Samatthe/TTL-HW/README.md

# TTL-HW
Hardware for the TelTail Light's Control Module, an interactive lighting controller for DIY electric skateboards
