Samatthe/TTL-HW/TTL-Lights/Tail Light/1v2/Tail Lights 1v2 BOM.xlsx

Parts | Value | Device | Package
J1 |  | JST_2MM_MALE | JST-2-SMD
R1 | 51 | RESISTOR2512 | 2512
J2 |  | JST_PH_2POS | JST_PH_2POS
D1 |  | MLERED-A1-0000-000V01
D2 |  | MLERED-A1-0000-000V01 | 4-SMD
D3 |  | MLERED-A1-0000-000V01 | 4-SMD
