Samatthe/TTL-HW/TTL-SP/BOM TTL SP 4v1.xlsx

# | Manufacturer Part# | Manufacturer | Value | Package | Designator | Quantity | Link | Note
1 | RMCF0603ZT0R00 | Stackpole Electronics Inc | 0 | 0603 | R19, R22 | 2 | https://www.digikey.com/product-detail/en/stackpole-electronics-inc/RMCF0603ZT0R00/RMCF0603ZT0R00CT-ND/1943218
2 | CS0603KRX7R7BB104 | Yageo | 0.1uf | 0603 | C1, C2, C3, C6, C7, C8, C20, C21 | 8 | https://www.digikey.com/product-detail/en/stackpole-electronics-inc/RMCF0402JT10K0/RMCF0402JT10K0CT-ND/1942936
3 | ERJ-P06J101V | Panasonic Electronic Components | 100 | 0805 | R35 | 1 | https://www.digikey.com/product-detail/en/panasonic-electronic-components/ERJ-P06J101V/P100ADCT-ND/525436
4 | RMCF0402JT10K0 | Stackpole Electronics Inc | 10k | 0402 | R1, R15, R16, R18, R20, R24, R25, R26, R27, R28, R29, R30, R31, R32, R33, R34 | 16 | https://www.digikey.com/product-detail/en/stackpole-electronics-inc/RMCF0402JT10K0/RMCF0402JT10K0CT-ND/1942936
5 | CL10X106MO8NRNC | Samsung Electro-Mechanics | 10uF, 16v | 0603 | C9 | 1 | https://www.digikey.com/product-detail/en/samsung-electro-mechanics/CL10X106MO8NRNC/1276-6769-1-ND/5961628
6 | CL10A106MA8NRNC | Samsung Electro-Mechanics | 10uF, 25v | 0603 | C10 | 1 | https://www.digikey.com/product-detail/en/samsung-electro-mechanics/CL10A106MA8NRNC/1276-1869-1-ND/3889955
7 | AIML-0603-100K-T | Abracon LLC | 10uH | 0603 | L1 | 1 | https://www.digikey.com/product-detail/en/abracon-llc/AIML-0603-100K-T/535-11587-1-ND/2782850
8 | RMCF0402FT140K | Stackpole Electronics Inc. | 140k | 0402 | R12 | 1 | https://www.digikey.com/product-detail/en/stackpole-electronics-inc/RMCF0402FT140K/RMCF0402FT140KCT-ND/5049718
9 | RMCF0402FT15K4 | Stackpole Electronics Inc | 15.4k | 0402 | R11 | 1 | https://www.digikey.com/product-detail/en/stackpole-electronics-inc/RMCF0402FT15K4/RMCF0402FT15K4CT-ND/6053094
10 | C1608C0G2A150J080AA | TDK Corporation | 15pf | 0603 | C4, C5 | 2 | https://www.digikey.com/product-detail/en/tdk-corporation/C1608C0G2A150J080AA/445-14008-1-ND/3955674
11 | ERJ-2RKF1743X | Panasonic Electronic Components | 174k | 0402 | R10 | 1 | https://www.digikey.com/product-detail/en/panasonic-electronic-components/ERJ-2RKF1743X/P174KLCT-ND/194213
12 | RMCF0402JT1K00 | Stackpole Electronics Inc | 1k | 0402 | R23 | 1 | https://www.digikey.com/product-detail/en/stackpole-electronics-inc/RMCF0402JT1K00/RMCF0402JT1K00CT-ND/1942934
13 | 1206L110/16WR | Littelfuse Inc. | 1.1A | 1206 | F1 | 1 | https://www.digikey.com/product-detail/en/littelfuse-inc/1206L110-16WR/18-1206L110-16WRCT-ND/10671937
14 | CGA6M3X7R1H225K200AB | TDK Corporation | 2.2uf | 1210 | C22 | 1 | https://www.digikey.com/product-detail/en/tdk-corporation/CGA6M3X7R1H225K200AB/445-5715-1-ND/2443755
15 | UZR1H2R2MCL1GB | Nichicon | 2.2uf | PANASONIC_B (4.30mm x 4.30mm) | C13 | 1 | https://www.digikey.com/product-detail/en/nichicon/UZR1H2R2MCL1GB/493-10122-1-ND/3983967
16 | GCM155R71H223KA55D | Murata Electronics North America | 22nf | 0402 | C14 | 1 | https://www.digikey.com/product-detail/en/murata-electronics-north-america/GCM155R71H223KA55D/490-4763-1-ND/1641682
17 | RMCF0402FT274K | Stackpole Electronics Inc | 274k | 0402 | R13 | 1 | https://www.digikey.com/product-detail/en/stackpole-electronics-inc/RMCF0402FT274K/RMCF0402FT274KCT-ND/6052917
18 | ABS07-32.768KHZ-T | Abracon LLC | 32.768kHz | SMD-3.2X1.5MM | Y1 | 1 | https://www.digikey.com/product-detail/en/abracon-llc/ABS07-32.768KHZ-T/535-9542-1-ND/1237009
19 | RMCF0402JT330R | Stackpole Electronics Inc | 330 | 0402 | R2, R3, R4, R5, R6, R7, R8, R9, R17, R21, R36 | 11 | https://www.digikey.com/product-detail/en/stackpole-electronics-inc/RMCF0402JT330R/RMCF0402JT330RCT-ND/2417869
20 | RMCF0603JT470K | Stackpole Electronics Inc. | 470k | 0603 | R14 | 1 | https://www.digikey.com/product-detail/en/stackpole-electronics-inc/RMCF0603JT470K/RMCF0603JT470KCT-ND/1943209
21 | GRM32EC81C476KE15K | Murata Electronics | 47uf | 1210 | C11, C12, C15 | 3 | https://www.digikey.com/product-detail/en/murata-electronics/GRM32EC81C476KE15K/490-16309-1-ND/7363291
22 | BC846B RFG | Taiwan Semiconductor Corporation | N/A | SOT23-3 | Q5, Q6 | 2 | https://www.digikey.com/product-detail/en/taiwan-semiconductor-corporation/BC846B-RFG/BC846BRFGCT-ND/7644289
23 | ATSAMD21G18A-AUT | Microchip Technology | N/A | 48-TQFP | U1 | 1 | https://www.digikey.com/product-detail/en/microchip-technology/ATSAMD21G18A-AUT/ATSAMD21G18A-AUTCT-ND/4878879
24 | AZ1117EH-3.3TRG1 | Diodes Incorporated | AZ1117EH-3.3 | SOT-223 | U4 | 1 | https://www.digikey.com/product-detail/en/diodes-incorporated/AZ1117EH-3.3TRG1/AZ1117EH-3.3TRG1DICT-ND/5001336
25 | 150060BS55040 | Wurth Electronics Inc. | Blue | 0603 | D4 | 1 | https://www.digikey.com/product-detail/en/wurth-electronics-inc/150060BS55040/732-12013-1-ND/8557223
26 | DMN3135LVT-7 | Diodes Incorporated | 3.5A | TSOT26 | Q1, Q2, Q3, Q4 | 4 | https://www.digikey.com/product-detail/en/diodes-incorporated/DMN3135LVT-7/DMN3135LVT-7DICT-ND/2890884
27 | 150060VS55040 | Wurth Electronics Inc. | Green | 0603 | D1 | 1 | https://www.digikey.com/product-detail/en/wurth-electronics-inc/150060VS55040/732-12017-1-ND/8557227
28 | LMZ35003RKGT | Texas Instruments | N/A | 41-BQFN | U2 | 1 | https://www.digikey.com/product-detail/en/texas-instruments/LMZ35003RKGT/296-37034-1-ND/4485013
29 | LSM6DSMTR | STMicroelectronics | N/A | 14-VFLGA | U7 | 1 | https://www.digikey.com/product-detail/en/stmicroelectronics/LSM6DSMTR/497-16696-1-ND/6192778
30 | PMEG6020ER,115 | Nexperia USA Inc. | .5v, 2A | SOD-123W | D3, D5 | 2 | https://www.digikey.com/product-detail/en/nexperia-usa-inc/PMEG6020ER,115/1727-5217-1-ND/2531816
31 | PSMN012-60YS,115 | Nexperia USA Inc. | 60v, 59A | LFPAK56, Power-SO8 | U6 | 1 | https://www.digikey.com/product-detail/en/nexperia-usa-inc/PSMN012-60YS,115/1727-4288-1-ND/2206354
32 | MPZ1608D300BTD25 | TDK Corporation | 30 Ohms @ 100MHz | 0603 | L2 | 1 | https://www.digikey.com/product-detail/en/tdk-corporation/MPZ1608D300BTD25/445-172886-1-ND/5040517
33 | SS215-HF | Comchip Technology | 100v, 2A | DO-214AC, SMA | D2 | 1 | https://www.digikey.com/product-detail/en/comchip-technology/SS215-HF/641-SS215-HFCT-ND/10443823
34 | USB3160-30-0170-1-C | GCT | N/A | N/A | J1 | 1 | https://www.digikey.com/product-detail/en/gct/USB3160-30-0170-1-C/2073-USB3160-30-0170-1-CCT-ND/9859727
