Samatthe/TTL-HW/TTL-Breakout/3D Parts/Pogo Cover.stl

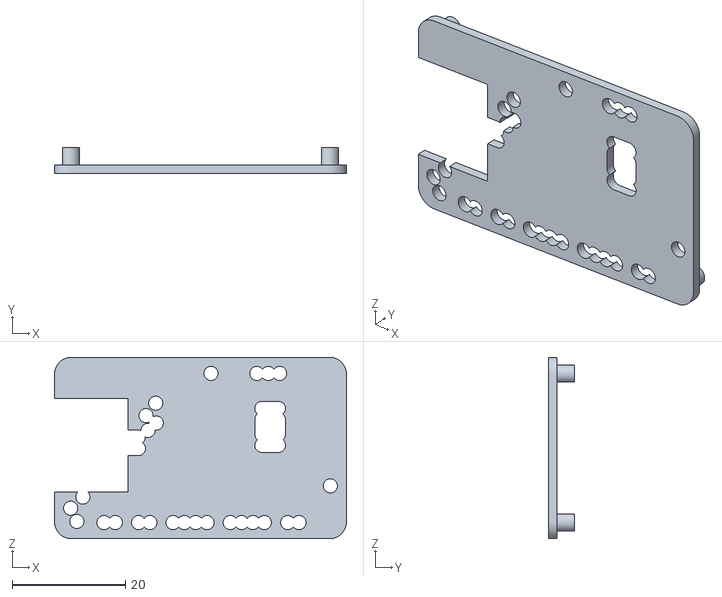
[picture p1: CAD file, 2023-09-26]
TTL-Breakout/3D Parts/Pogo Cover.stl
51.5 x 4.50 x 32.0
