Samatthe/TTL-HW/TTL-EP/3D Models/TTL EP Cover 2v1.stl

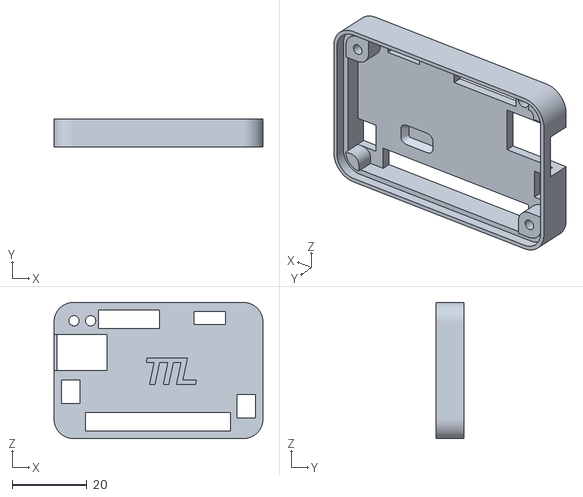
[picture p2: CAD file, 2023-09-26]
TTL-EP/3D Models/TTL EP Cover 2v1.stl
55.9 x 7.60 x 36.4
