Samatthe/TTL-HW/TTL-Lights/3D Models/Head Cover.stl

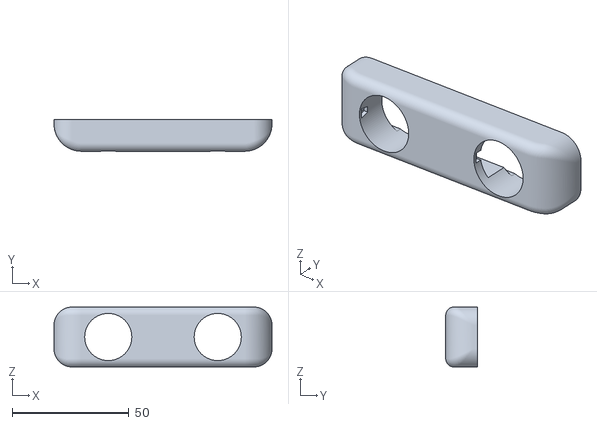
[picture p3: CAD file, 2023-09-26]
TTL-Lights/3D Models/Head Cover.stl
93.6 x 13.5 x 25.7
