Samatthe/TTL-HW/TTL-EP/3D Models/TTL EP Base 2v1.stl

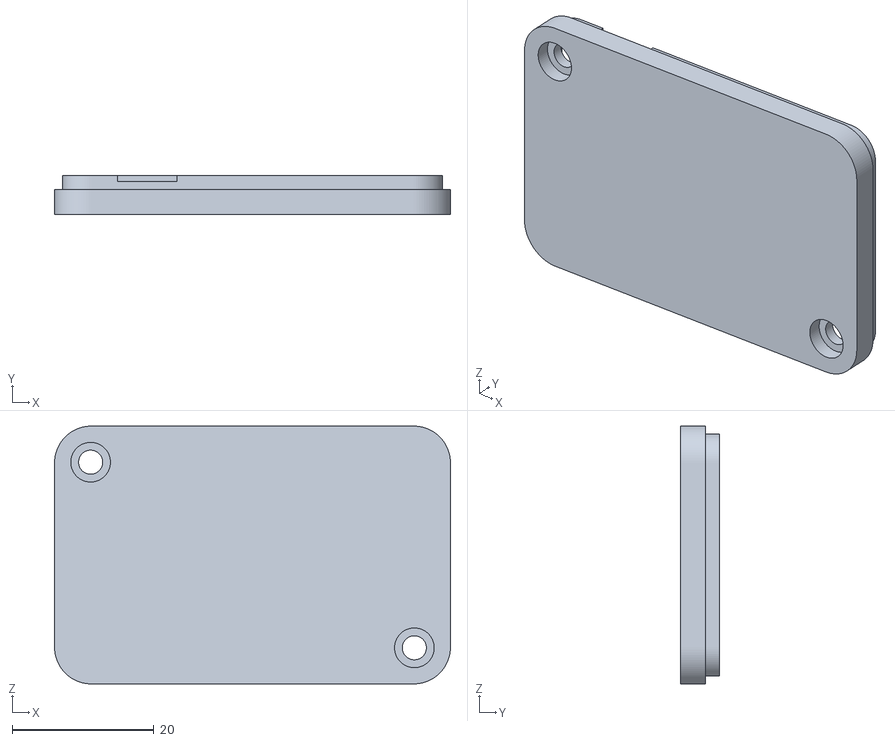
[picture p5: CAD file, 2023-09-26]
TTL-EP/3D Models/TTL EP Base 2v1.stl
55.9 x 5.50 x 36.4
