Samatthe/TTL-HW/TTL-Lights/3D Models/Light Mount.stl

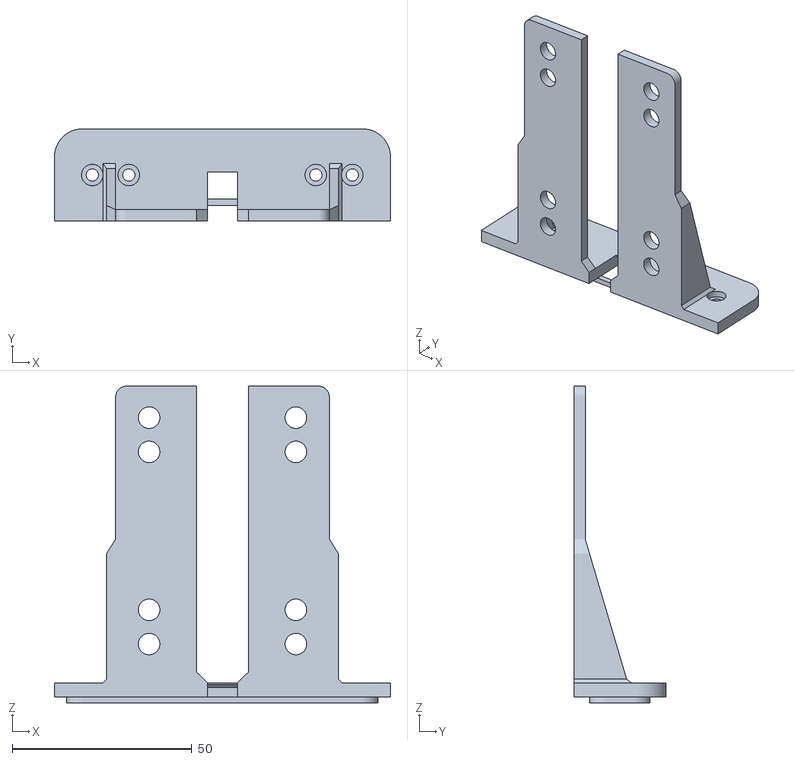
[picture p6: CAD file, 2023-09-26]
TTL-Lights/3D Models/Light Mount.stl
93.6 x 25.7 x 88.2
