Samatthe/TTL-HW/TTL-SP/3D Models/TTL SP Cover 4v1 - Printed.stl

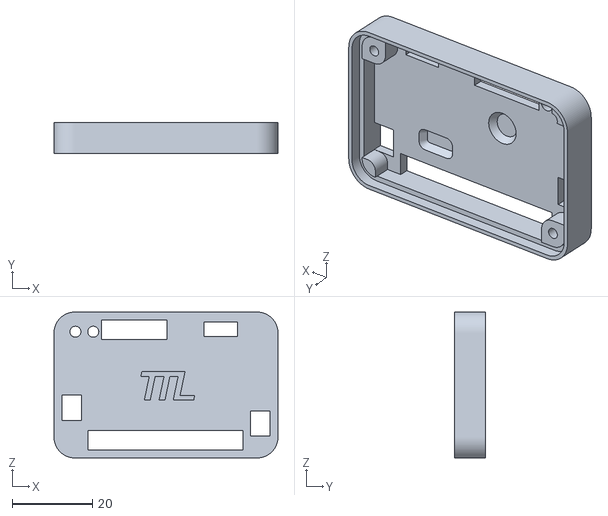
[picture p7: CAD file, 2023-09-26]
TTL-SP/3D Models/TTL SP Cover 4v1 - Printed.stl
55.9 x 7.80 x 36.4
