Samatthe/TTL-HW/TTL-Lights/3D Models/LightCover - Tail 45 deg.stl

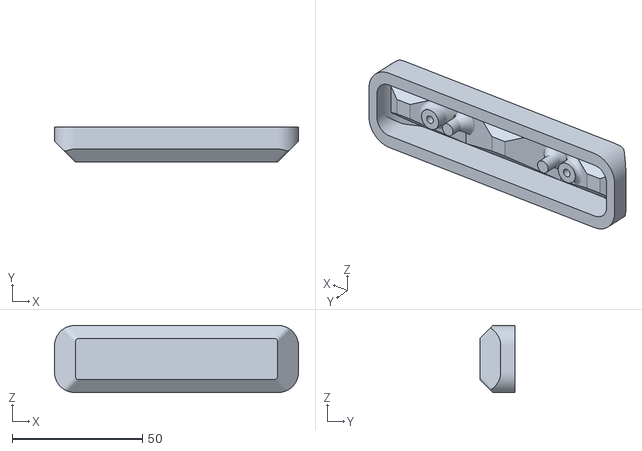
[picture p8: CAD file, 2023-09-26]
TTL-Lights/3D Models/LightCover - Tail 45 deg.stl
93.6 x 13.5 x 25.7
