Samatthe/TTL-HW/TTL-SP/3D Models/Cover SP Metal v29.step

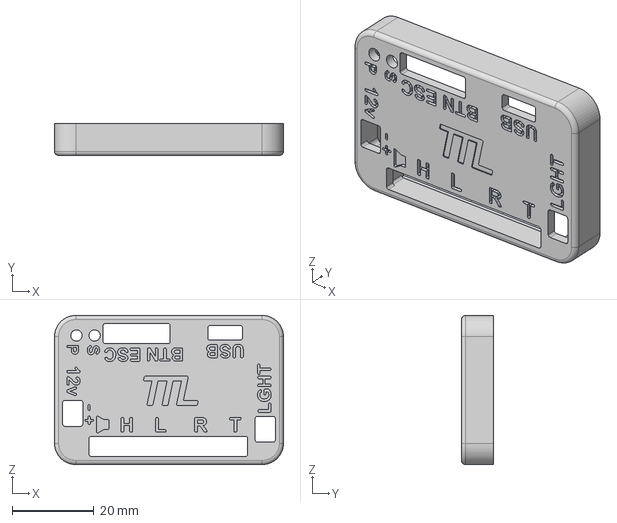
[picture p9: CAD file, 2023-09-26]
TTL-SP/3D Models/Cover SP Metal v29.step
55.9 x 7.80 x 36.4 mm
