Samatthe/TTL-HW/TTL-SP/3D Models/Base SP - Countersunk Screw.stl

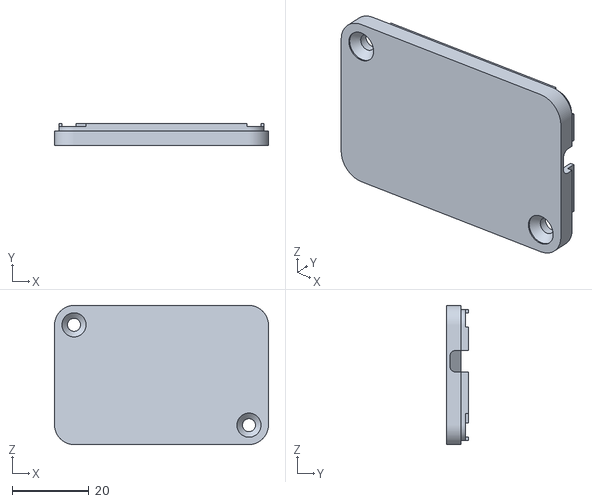
[picture p10: CAD file, 2023-09-26]
TTL-SP/3D Models/Base SP - Countersunk Screw.stl
55.9 x 5.70 x 36.4
