Samatthe/TTL-HW/(list of files, cad)

Other CAD files:
TTL-SP/3D Models/TTL SP Cover 4v1 - Metal.stl
TTL-SP/3D Models/Base SP - Pan Head Screw.stl
