Samatthe/TTL-HW/TTL-Lights/Headlight/1v2/Head Lights.brd

## EAGLE design TTL-Lights/Headlight/1v2/Head Lights.brd (2023-09-26)

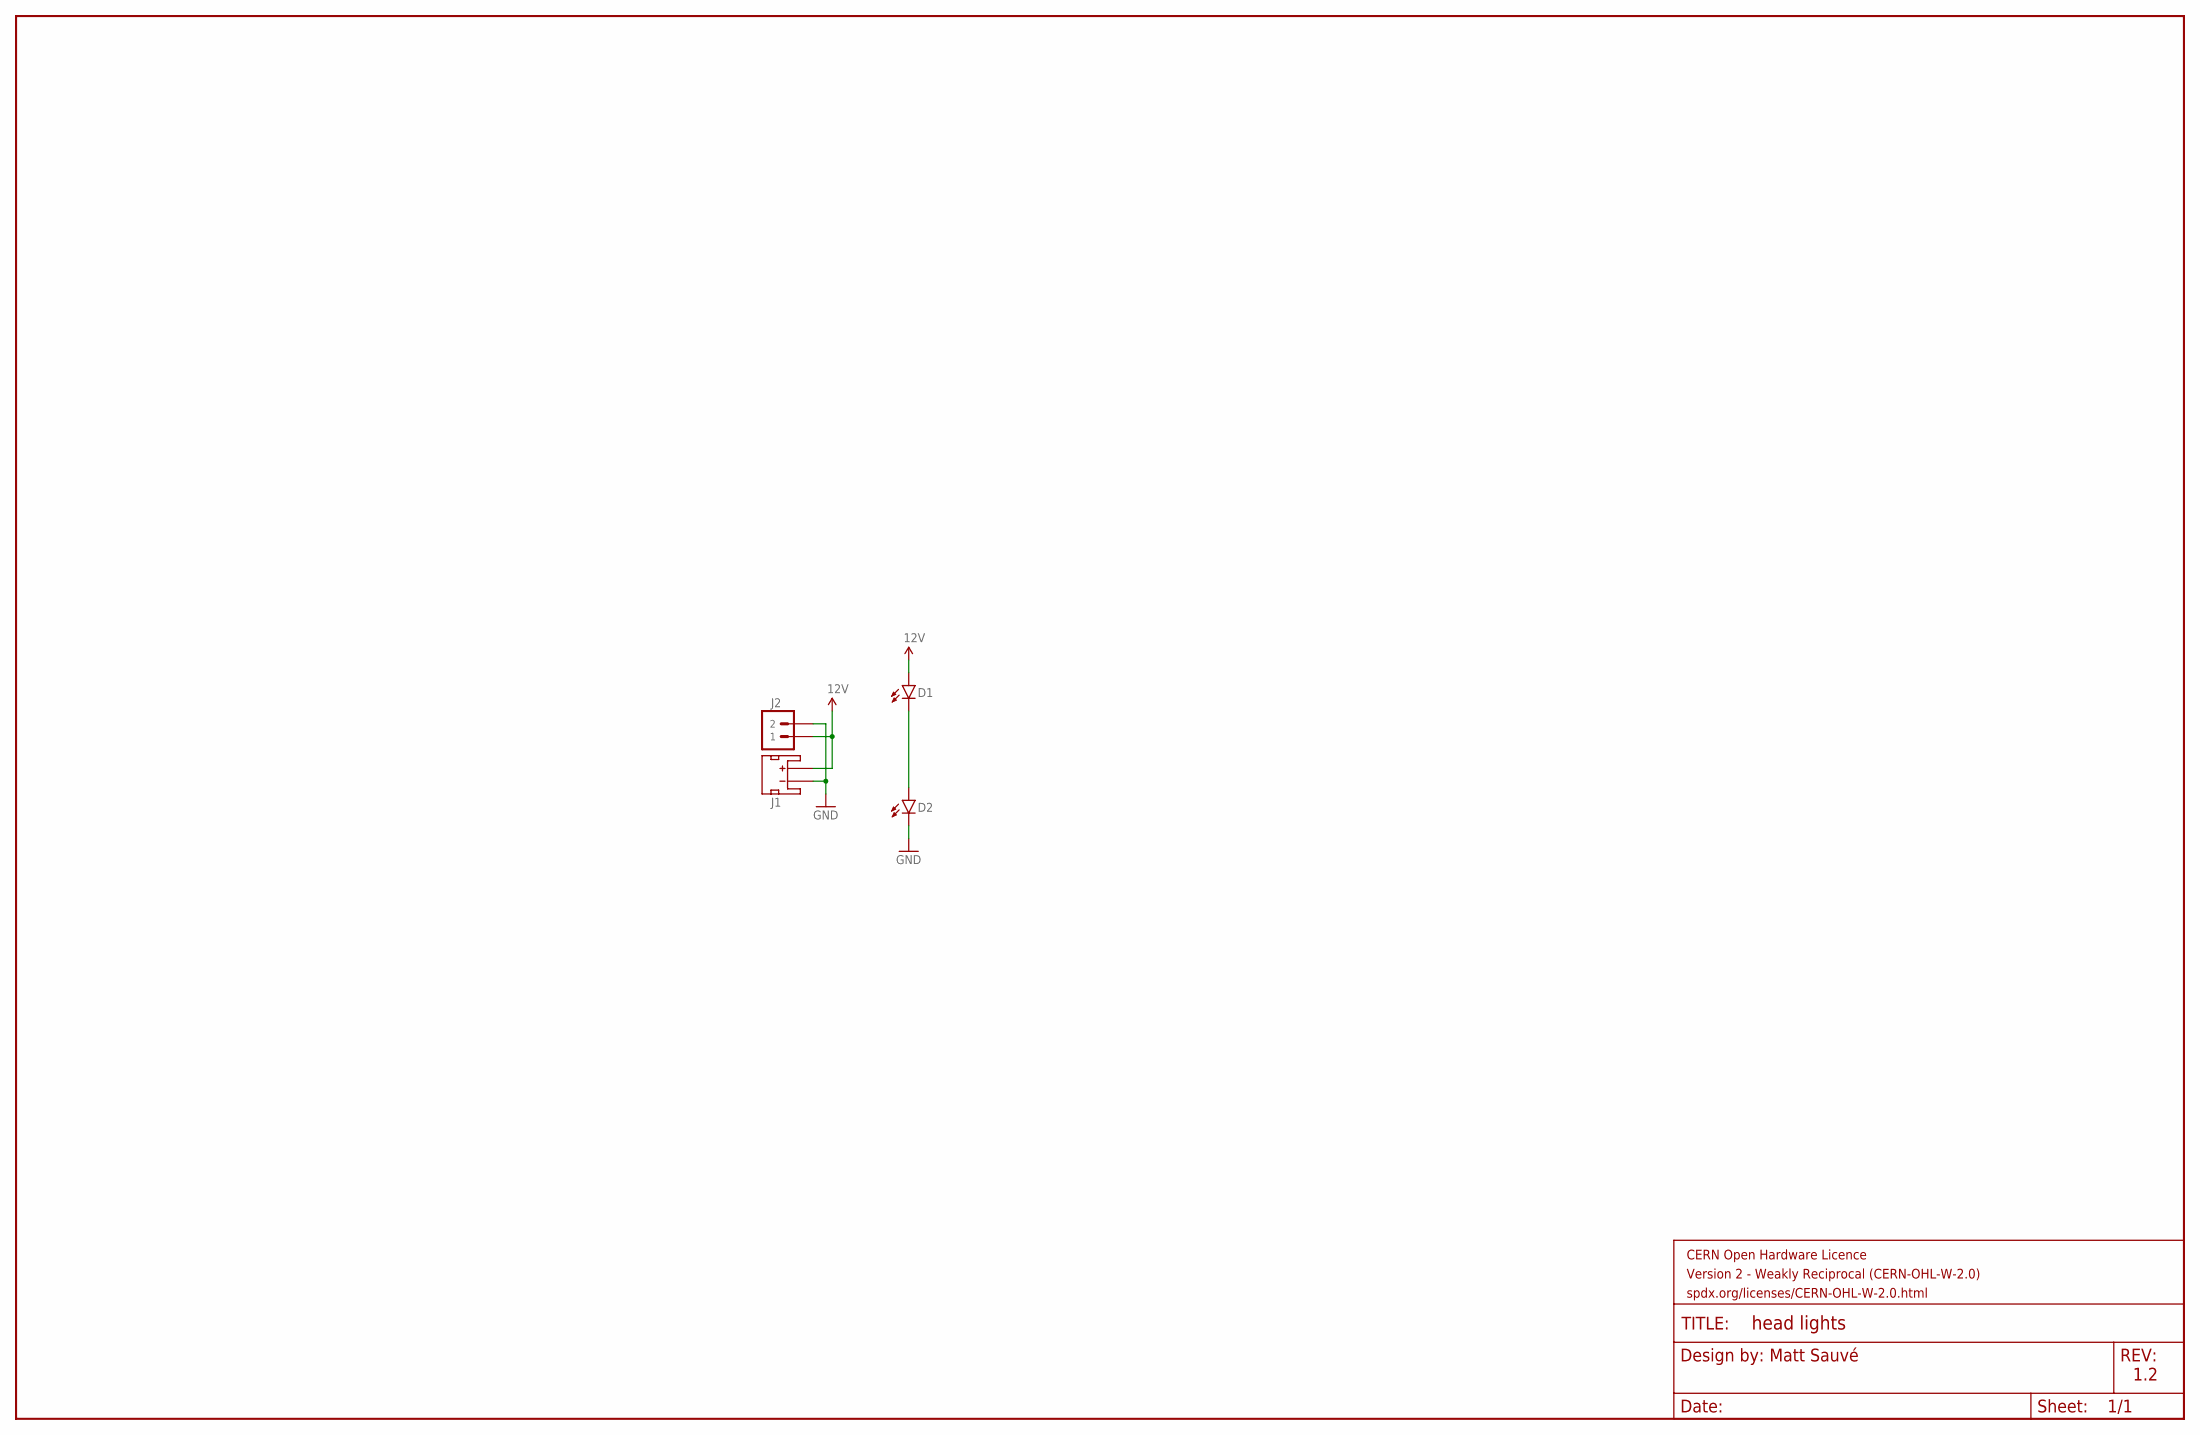
[picture p11: schematic Head Lights.sch]

Parts:
D1, D2: WHITE_LUXEON_LED; 1414
FRAME1: FRAME-LEDGER_CERN_WEAK; CERN_WEAK
J1: JST_2MM_MALE; JST-2-SMD
J2: JST_PH_2POS

Connections:
12V: D1.P$1 (A), J1.2 (+), J2.1
GND: D2.P$2 (C), J1.1 (-), J2.2
unnamed: D1.P$2 (C), D2.P$1 (A)

Notes on the sheet:
Matt Sauvé
1.2

Board: 2 copper layers, 5 parts (2 on the bottom side), 3 nets, no tracks yet.
