Samatthe/TTL-HW/TTL-Breakout/TelTail Breakout 3v0.brd

## EAGLE design TTL-Breakout/TelTail Breakout 3v0.brd (2023-09-26)

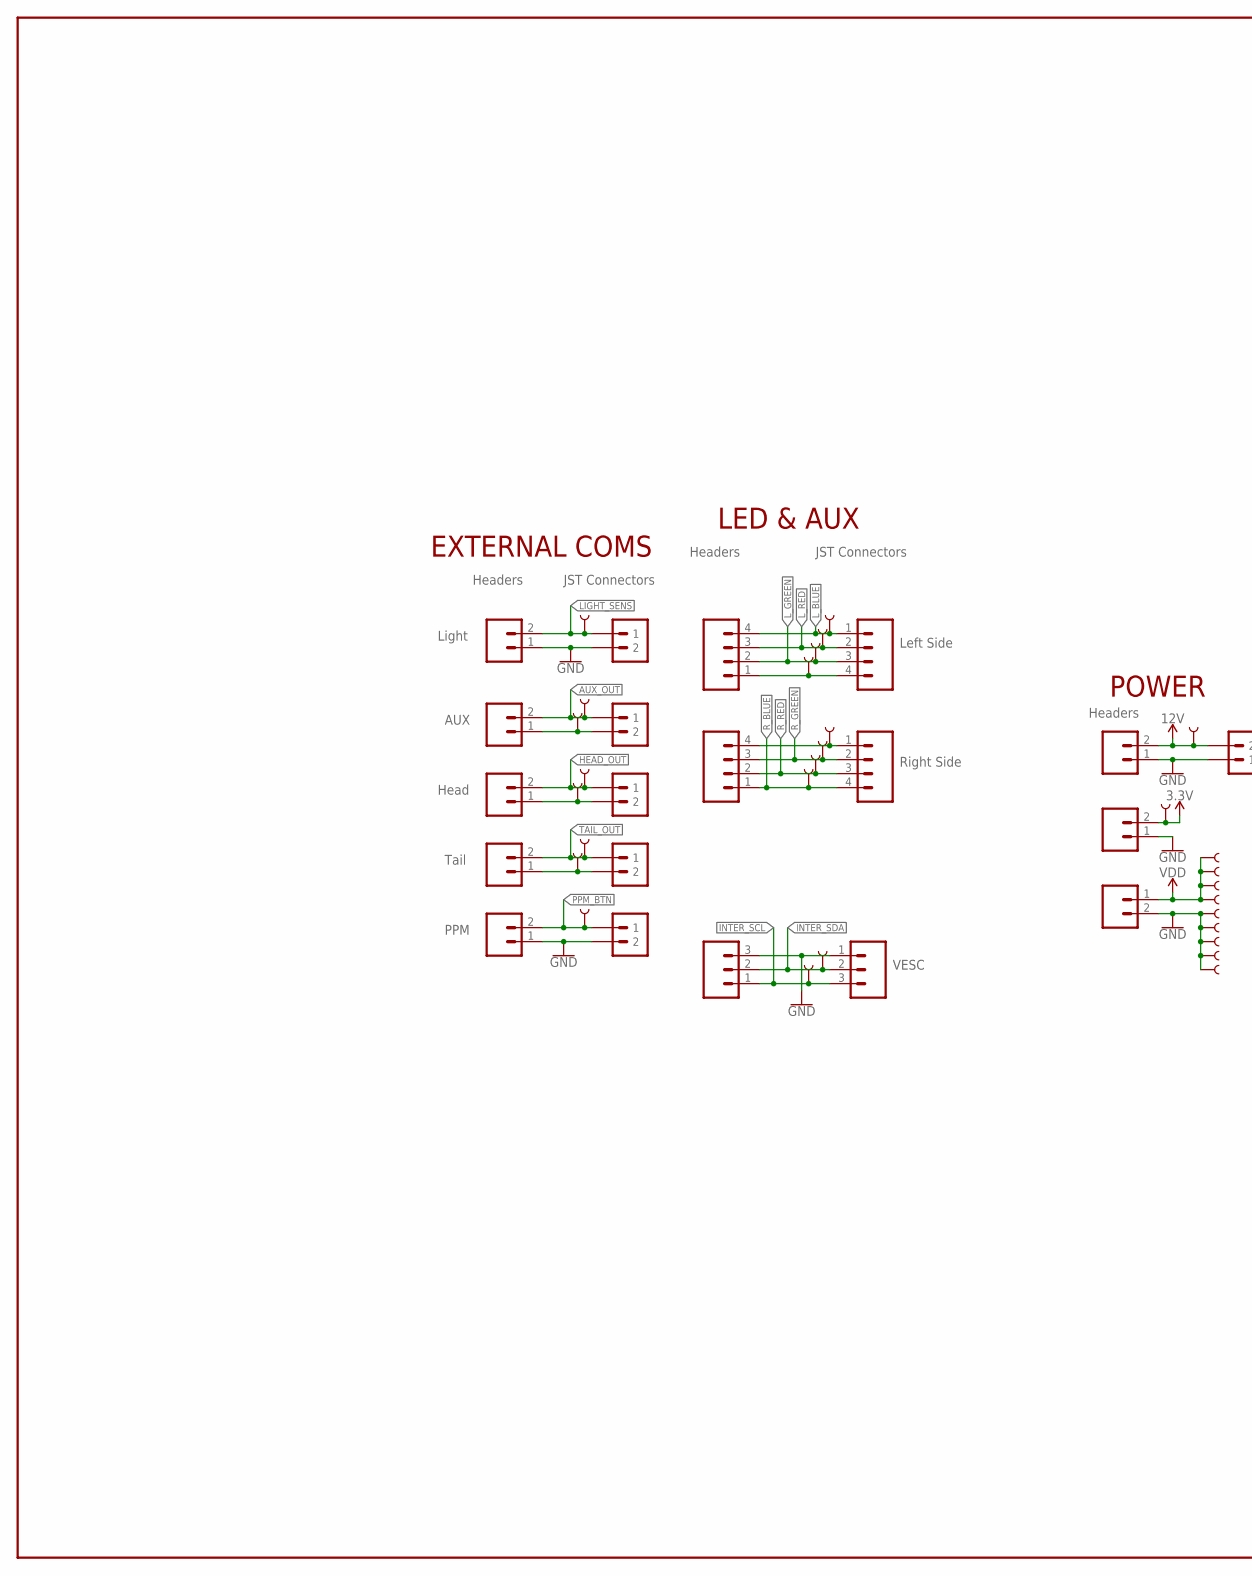
[picture p12: schematic TelTail Breakout 3v0.sch, part in row 1, column 1]

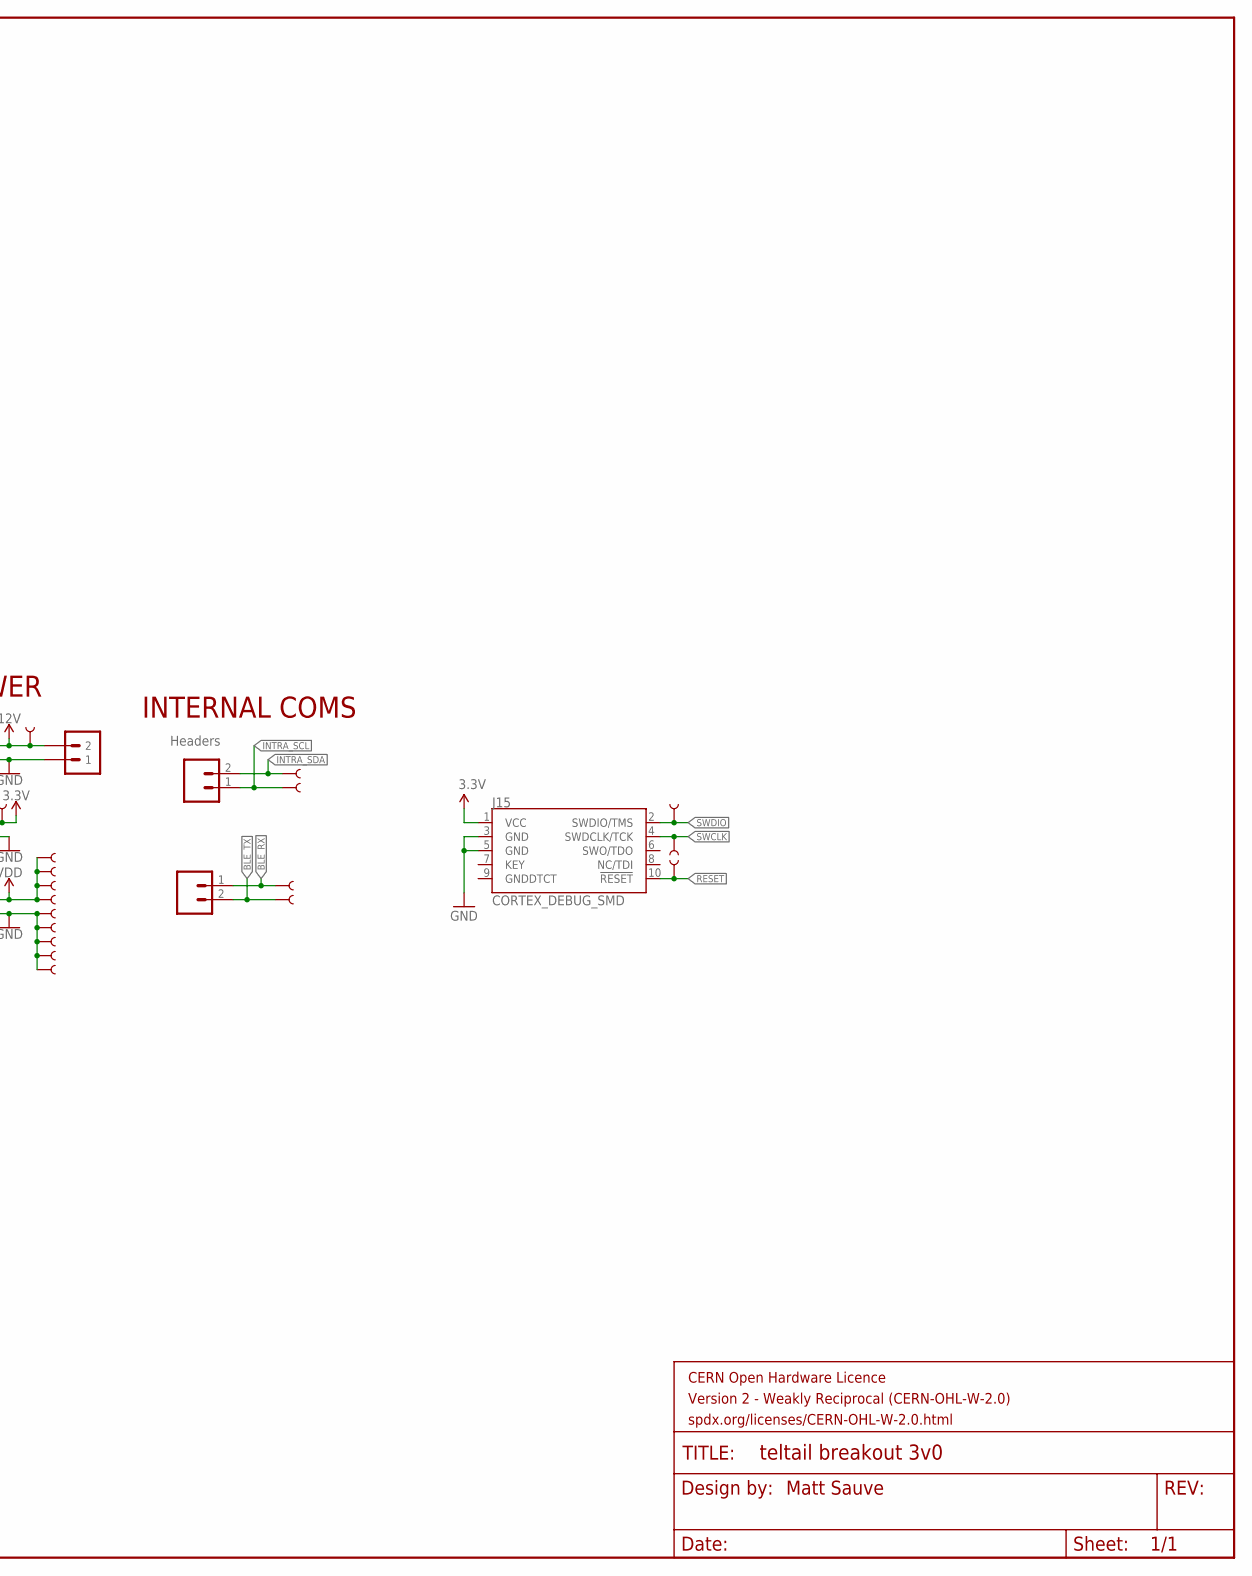
[picture p13: schematic TelTail Breakout 3v0.sch, part in row 1, column 2]

Parts:
FRAME1: FRAME-LEDGER_CERN_WEAK; CERN_WEAK
J1, J2, J3, J4, J5, J6, J11, J12, J13, J14: CONN_02; 1X02
J7: CONN_03; 1X03
J9, J10: CONN_04; 1X04
J15: CORTEX_DEBUG_SMD; SAMTECH_FTSH-105-01
U$1, U$2, U$3, U$4, U$5, U$45: JST_PH_2POS
U$6, U$11, U$12, U$13, U$14, U$15, U$16, U$17, U$18, U$19, U$20, U$21, U$22, U$23, U$24, U$25, U$26, U$27, U$28, U$29, U$30, U$31, U$32, U$33, U$34, U$35, U$36, U$37, U$38, U$39, U$40, U$42, U$43, U$44, U$46, U$48: POGO_PIN_90173-AS
U$8, U$10: JST_PH_4POS
U$9: JST_PH_3POS

Connections:
3.3V: J12.2, J15.1 (VCC), U$20.P$1
12V: J11.2, U$38.P$1, U$45.2
!RESET: J15.10 (!RESET), U$36.P$1
AUX_OUT: J2.2, U$4.1, U$31.P$1
BLE_RX: J14.1, U$46.P$1
BLE_TX: J14.2, U$48.P$1
GND: J1.1, J5.1, J6.2, J7.3, J11.1, J12.1, J15.3 (GND), J15.5 (GND), U$1.2, U$5.2, U$6.P$1, U$9.1 (2), U$24.P$1, U$28.P$1, U$30.P$1, U$40.P$1, U$45.1
HEAD_OUT: J3.2, U$3.1, U$29.P$1
INTER_SCL: J7.1, U$9.3 (4), U$19.P$1
INTER_SDA: J7.2, U$9.2 (3), U$21.P$1
INTRA_SCL: J13.1, U$44.P$1
INTRA_SDA: J13.2, U$43.P$1
LIGHT_SENS: J1.2, U$5.1, U$33.P$1
L_BLUE: J10.4, U$10.1, U$11.P$1
L_GREEN: J10.2, U$10.3, U$13.P$1
L_RED: J10.3, U$10.2, U$12.P$1
unnamed: J4.1, U$2.2, U$35.P$1
unnamed: J3.1, U$3.2, U$34.P$1
unnamed: J2.1, U$4.2, U$32.P$1
unnamed: J10.1, U$10.4, U$14.P$1
unnamed: J9.4, U$8.1, U$15.P$1
PPM_BTN: J5.2, U$1.1, U$25.P$1
R_BLUE: J9.1, U$8.4, U$18.P$1
R_GREEN: J9.3, U$8.2, U$16.P$1
R_RED: J9.2, U$8.3, U$17.P$1
SWCLK: J15.4 (SWDCLK/TCK), U$37.P$1
SWDIO: J15.2 (SWDIO/TMS), U$39.P$1
TAIL_OUT: J4.2, U$2.1, U$27.P$1
VDD: J6.1, U$22.P$1, U$23.P$1, U$26.P$1, U$42.P$1

Notes on the sheet:
VESC
Right Side
Left Side
JST Connectors
Headers
Light
AUX
Head
Tail
PPM
POWER
LED & AUX
EXTERNAL COMS
INTERNAL COMS
Matt Sauve

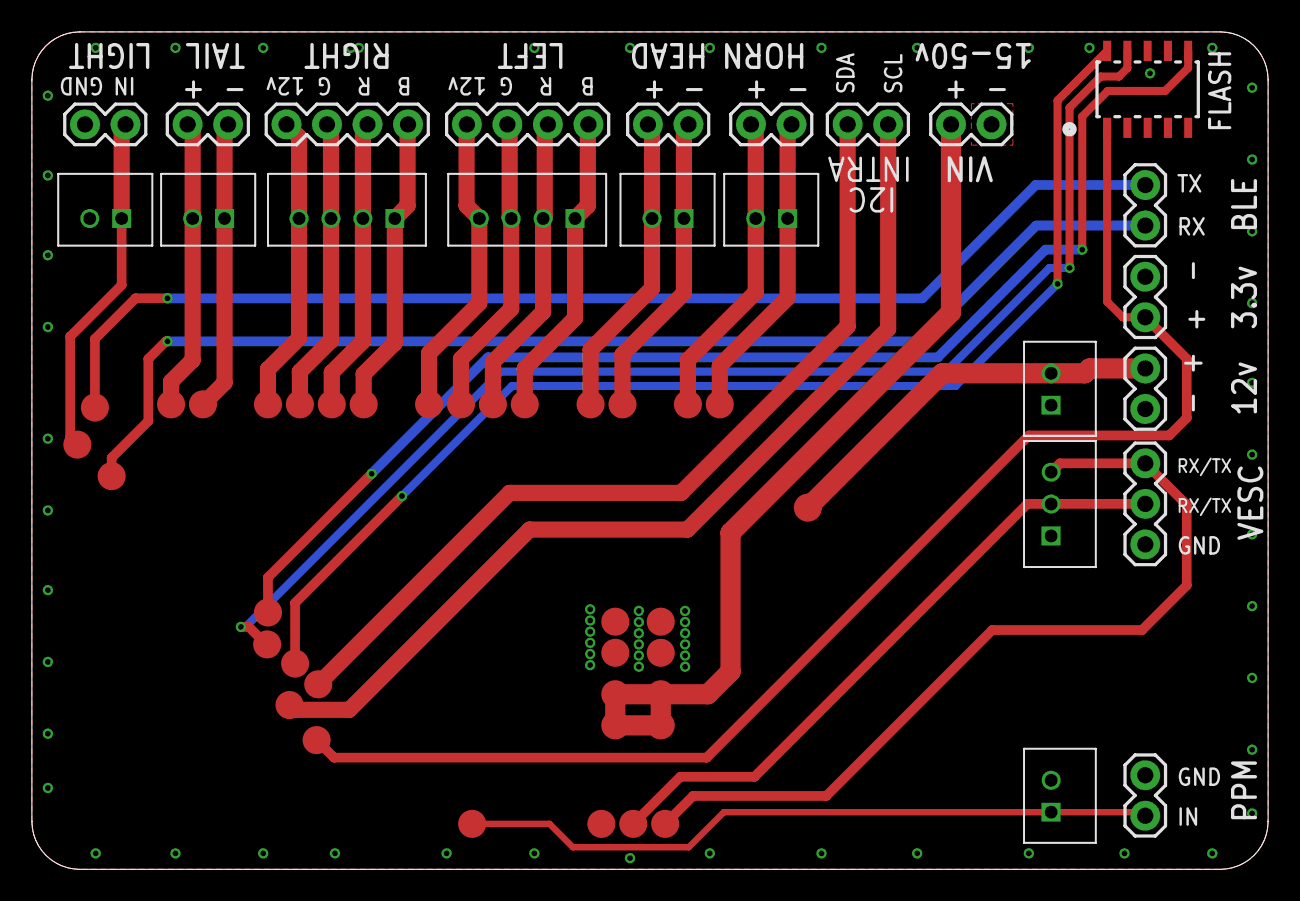
[picture p14: board TelTail Breakout 3v0.brd from above]

Board: 2 copper layers, 77.5 x 52.5 mm, 61 parts (1 on the bottom side), 29 nets.

Other parts of the board:
U$41: TTL_LARGE
