Samatthe/TTL-HW/TTL-EP/TelTail Lights EP 2v1.brd

## EAGLE design TTL-EP/TelTail Lights EP 2v1.brd (2023-09-26)

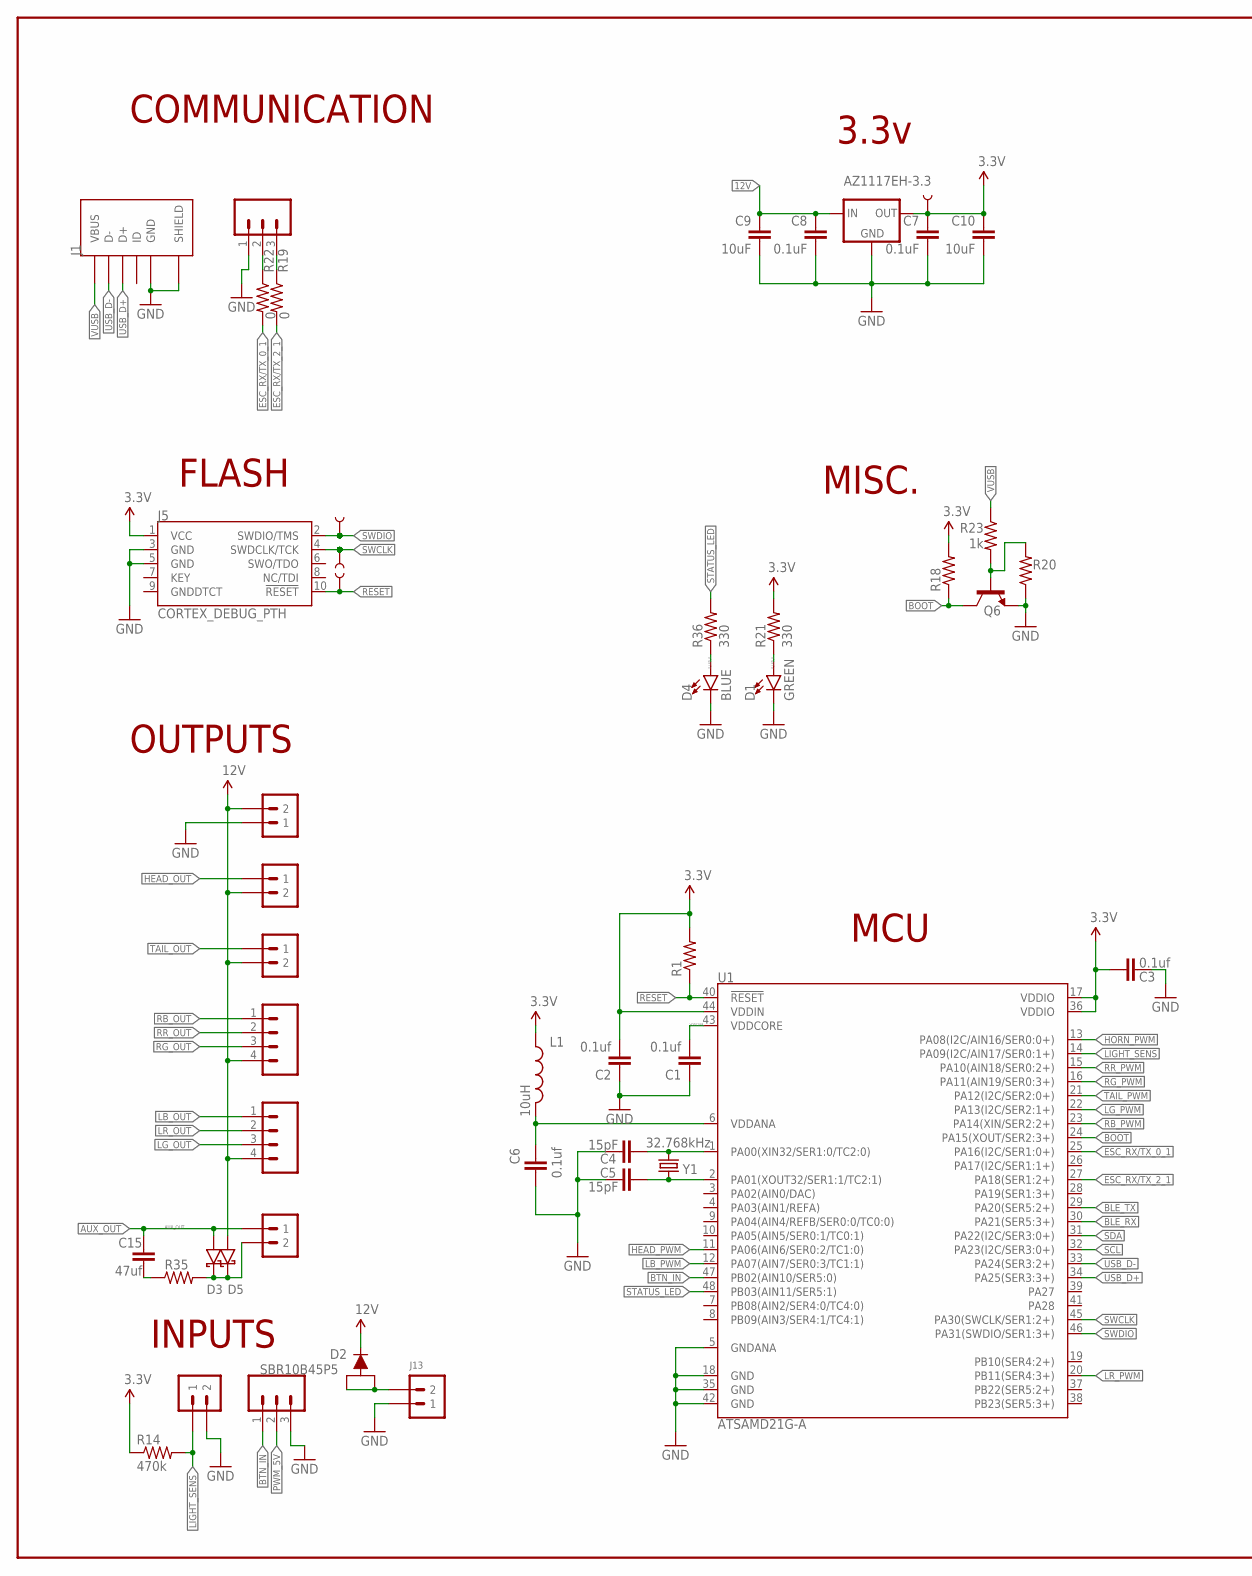
[picture p15: schematic TelTail Lights EP 2v1.sch, part in row 1, column 1]

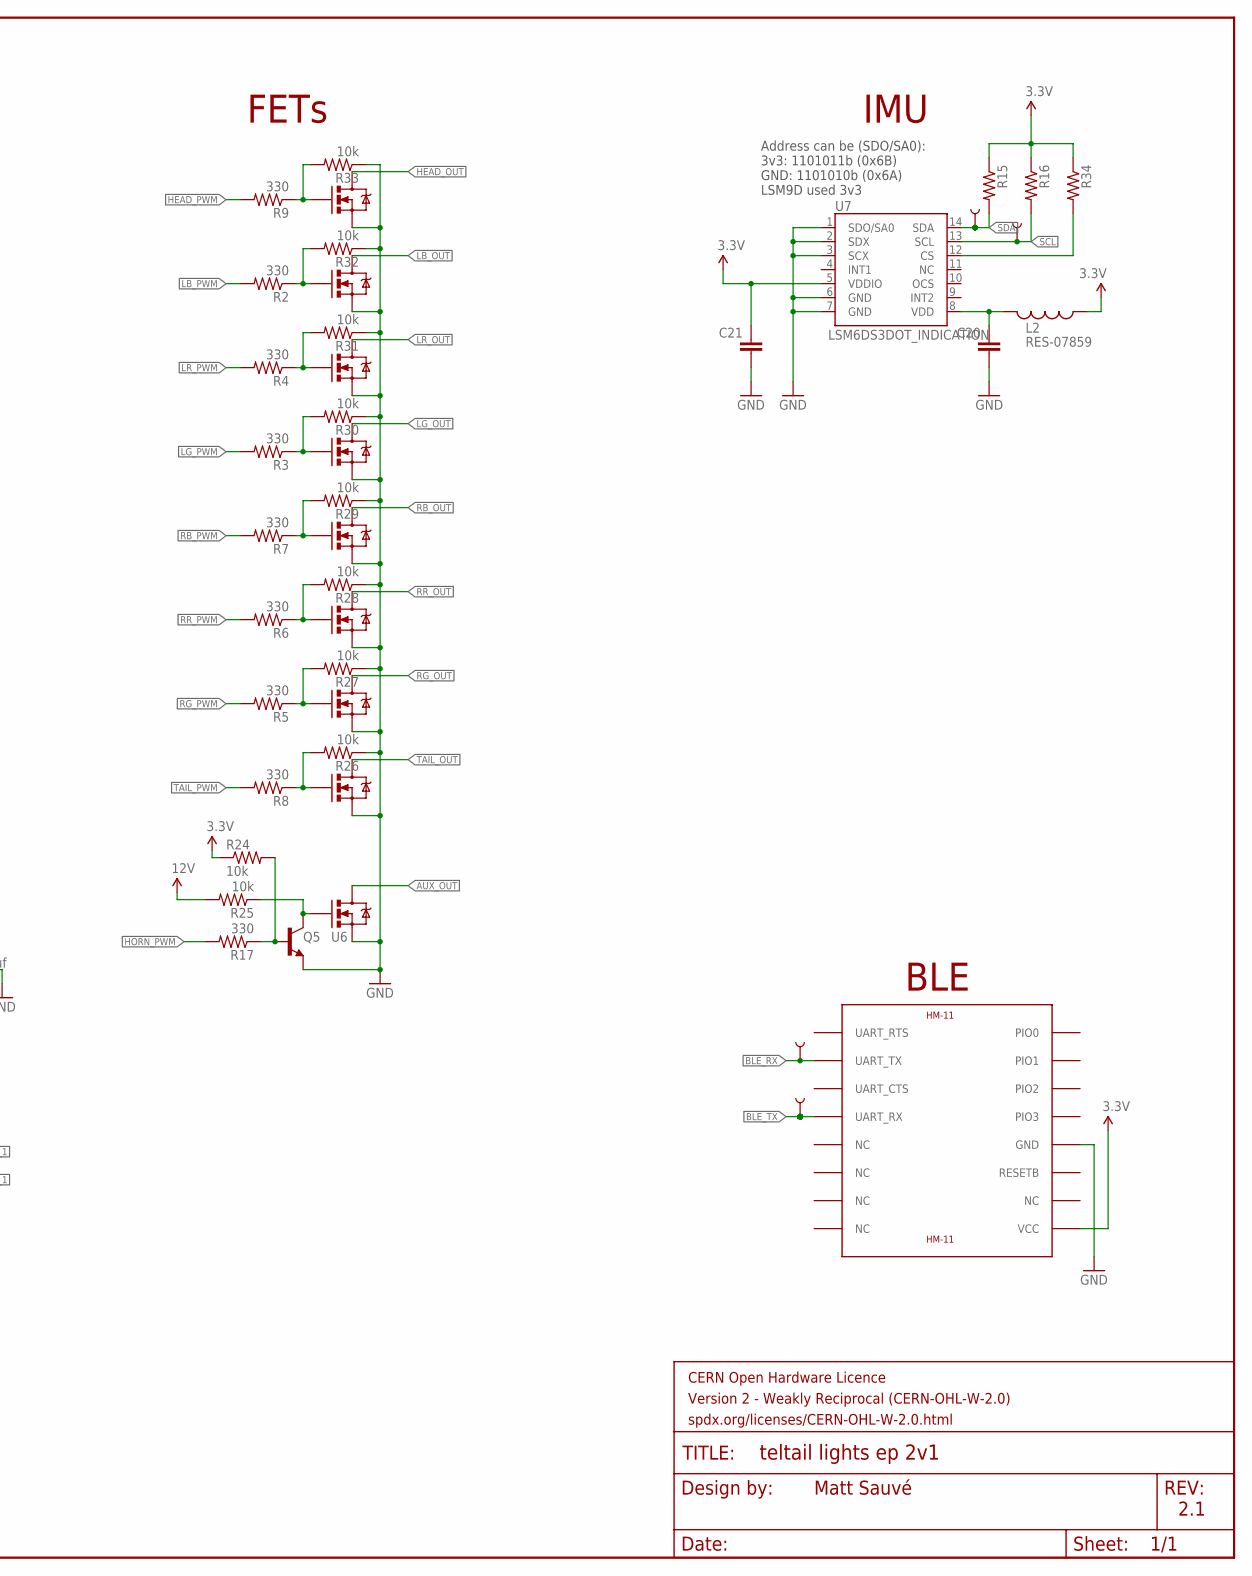
[picture p16: schematic TelTail Lights EP 2v1.sch, part in row 1, column 2]

Parts:
C1, C2, C3, C6: 0.1uf; 0603-CAP
C4, C5: 15pF; 0603-CAP
C7, C8, C20, C21: 0.1uF; 0603-CAP
C9, C10: 10uF; 0603-CAP
C15: 47uf; 1210-CAP
D1: GREEN; LED-0603-2
D2: SBR10B45P5; POWERDI5
D3, D5: PMEG2010ER; SOD-123W
D4: BLUE; LED-0603-2
FRAME1: FRAME-LEDGER_CERN_WEAK; CERN_WEAK
J1: USB3160-XX-XXXX-X-X_REVA; GCT_USB3160-XX-XXXX-X-X_REVA
J3, J12: JST_PH_3POS
J4, J6, J7, J10, J11: JST_PH_2POS
J5: CORTEX_DEBUG_PTH; 2X5-PTH-1.27MM-2
J8, J9: JST_PH_4POS
J13: TERM_BLOCK_SPRING_2POS_5MM
L1: 10uH; 0603-IND
L2: RES-07859; 0603-IND
Q1, Q2, Q3, Q4: DUAL_NFET_3.5A; TSOT26
Q5, Q6: 500mA/300V; SOT23-3
R1, R15, R16, R18, R20, R24, R25, R26, R27, R28, R29, R30, R31, R32, R33, R34: 10k; RES-0402
R2, R3, R4, R5, R6, R7, R8, R9, R17, R21, R36: 330; RES-0402
R14: 470k; RES-0603
R19, R22: 0; RES-0603
R23: 1k; RES-0402
R35: 100; 0805-RES
TP1, TP2, TP3, TP4, TP5, TP8, TP9, TP10: 1MM_TP
U1: ATSAMD21G-A; TQFP-48
U3: HM-11
U4: AZ1117EH-3.3; SOT-223
U6: PSMN8R5-60YS; SOT669
U7: LSM6DS3DOT_INDICATION; LGA14L_DOT_INDICATOR
Y1: 32.768kHz; CRYSTAL-SMD-3.2X1.5MM

Connections:
3.3V: C2.2, C3.2, C7.1, C10.1, C21.1, J5.1 (VCC), L1.1, L2.1, R1.2, R14.1, R15.1, R16.1, R18.2, R21.2, R24.1, R34.1, TP3.P$1, U1.17 (VDDIO), U1.36 (VDDIO), U1.44 (VDDIN), U3.VCC, U4.2 (OUT), U4.4 (OUT), U7.5 (VDDIO)
12V: C8.1, C9.1, D2.CATHODE (C), D5.2 (ANODE), J4.2, J6.2, J7.2, J8.4, J9.4, R25.2, U4.3 (IN)
!RESET: J5.10 (!RESET), R1.1, TP10.P$1, U1.40 (!RESET!)
AUX_OUT: C15.1, D3.2 (ANODE), J10.1, U6.P$1 (D), U6.P$2 (D)
BLE_RX: TP2.P$1, U1.30 (PA21(SER5:3+)), U3.UART_TX
BLE_TX: TP1.P$1, U1.29 (PA20(SER5:2+)), U3.UART_RX
BOOT: Q6.3 (C), R18.1, U1.24 (PA15(XOUT/SER2:3+))
BTN_IN: J12.1 (2), U1.47 (PB02(AIN10/SER5:0))
ESC_RX/TX_0_0: J3.2 (3), R22.1
ESC_RX/TX_0_1: R22.2, U1.25 (PA16(I2C/SER1:0+))
ESC_RX/TX_2_0: J3.3 (4), R19.1
ESC_RX/TX_2_1: R19.2, U1.27 (PA18(SER1:2+))
GND: C1.1, C2.1, C3.1, C4.2, C5.2, C6.2, C7.2, C8.2, C9.2, C10.2, C20.2, C21.2, D1.C, D4.C, J1.5 (GND), J1.6 (SHIELD), J1.7 (SHIELD), J1.8 (SHIELD), J3.1 (2), J4.1, J5.3 (GND), J5.5 (GND), J11.2, J12.3 (4), J13.P1_1 (1), J13.P1_2 (1), Q1.2 (S), Q1.5 (S), Q2.2 (S), Q2.5 (S), Q3.2 (S), Q3.5 (S), Q4.2 (S), Q4.5 (S), Q5.2 (E), Q6.2 (E), R20.1, R26.1, R27.1, R28.1, R29.1, R30.1, R31.1, R32.1, R33.1, U1.5 (GNDANA), U1.18 (GND), U1.35 (GND), U1.42 (GND), U3.GND, U4.1 (GND), U6.1 (S), U6.2 (S), U6.3 (S), U7.1 (SDO/SA0), U7.2 (SDX), U7.3 (SCX), U7.6 (GND), U7.7 (GND)
HEAD_OUT: J6.1, Q1.4 (D)
HEAD_PWM: R9.2, U1.11 (PA06(AIN6/SER0:2/TC1:0))
HORN_PWM: R17.2, U1.13 (PA08(I2C/AIN16/SER0:0+))
IMU_CS: R34.2, U7.12 (CS)
LB_OUT: J9.1, Q1.6 (D)
LB_PWM: R2.2, U1.12 (PA07(AIN7/SER0:3/TC1:1))
LG_OUT: J9.3, Q2.6 (D)
LG_PWM: R3.2, U1.22 (PA13(I2C/SER2:1+))
LIGHT_SENS: J11.1, R14.2, U1.14 (PA09(I2C/AIN17/SER0:1+))
LR_OUT: J9.2, Q2.4 (D)
LR_PWM: R4.2, U1.20 (PB11(SER4:3+))
unnamed: Q1.1 (G), R2.1, R32.2
unnamed: Q1.3 (G), R9.1, R33.2
unnamed: D3.1 (CATHODE), D5.1 (CATHODE), J10.2, R35.2
unnamed: C6.1, L1.2, U1.6 (VDDANA)
unnamed: Q2.3 (G), R4.1, R31.2
unnamed: Q2.1 (G), R3.1, R30.2
unnamed: Q3.3 (G), R7.1, R29.2
unnamed: Q3.1 (G), R6.1, R28.2
unnamed: Q4.3 (G), R5.1, R27.2
unnamed: Q4.1 (G), R8.1, R26.2
unnamed: Q5.1 (B), R17.1, R24.2
unnamed: Q6.1 (B), R20.2, R23.2
unnamed: C15.2, R35.1
unnamed: Q5.3 (C), R25.1, U6.4 (G)
unnamed: C5.1, U1.2 (PA01(XOUT32/SER1:1/TC2:1)), Y1.P$1 (1)
PWM_5V: J12.2 (3)
P_LED_0: D1.A, R21.1
RB_OUT: J8.1, Q3.4 (D)
RB_PWM: R7.2, U1.23 (PA14(XIN/SER2:2+))
RG_OUT: J8.3, Q4.4 (D)
RG_PWM: R5.2, U1.16 (PA11(AIN19/SER0:3+))
RR_OUT: J8.2, Q3.6 (D)
RR_PWM: R6.2, U1.15 (PA10(AIN18/SER0:2+))
SCL: R16.2, TP5.P$1, U1.32 (PA23(I2C/SER3:0+)), U7.13 (SCL)
SDA: R15.2, TP4.P$1, U1.31 (PA22(I2C/SER3:0+)), U7.14 (SDA)
STATUS_LED: R36.2, U1.48 (PB03(AIN11/SER5:1))
SWCLK: J5.4 (SWDCLK/TCK), TP9.P$1, U1.45 (PA30(SWCLK/SER1:2+))
SWDIO: J5.2 (SWDIO/TMS), TP8.P$1, U1.46 (PA31(SWDIO/SER1:3+))
S_LED_0: D4.A, R36.1
TAIL_OUT: J7.1, Q4.6 (D)
TAIL_PWM: R8.2, U1.21 (PA12(I2C/SER2:0+))
USB_D+: J1.3 (D+), U1.34 (PA25(SER3:3+))
USB_D-: J1.2 (D-), U1.33 (PA24(SER3:2+))
VCC: D2.ANODE1 (A), D2.ANODE2 (A1), J13.P2_1 (2), J13.P2_2 (2)
VDD: C20.1, L2.2, U7.8 (VDD)
VDDANA: C4.1, U1.1 (PA00(XIN32/SER1:0/TC2:0)), Y1.P$2 (2)
VDDCORE: C1.2, U1.43 (VDDCORE)
VUSB: J1.1 (VBUS), R23.1

Notes on the sheet:
COMMUNICATION
INPUTS
IMU
OUTPUTS
3.3v
BLE
MISC.
FETs
MCU
FLASH
Matt Sauvé
2.1
Address can be (SDO/SA0): 3v3: 1101011b (0x6B) GND: 1101010b (0x6A) LSM9D used 3v3

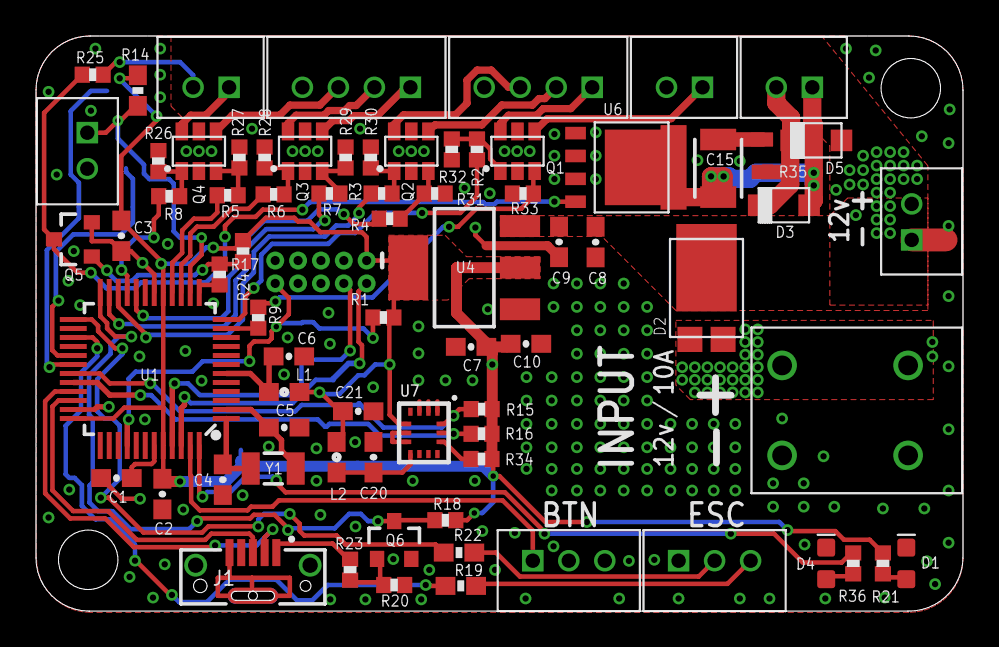
[picture p17: board TelTail Lights EP 2v1.brd from above]

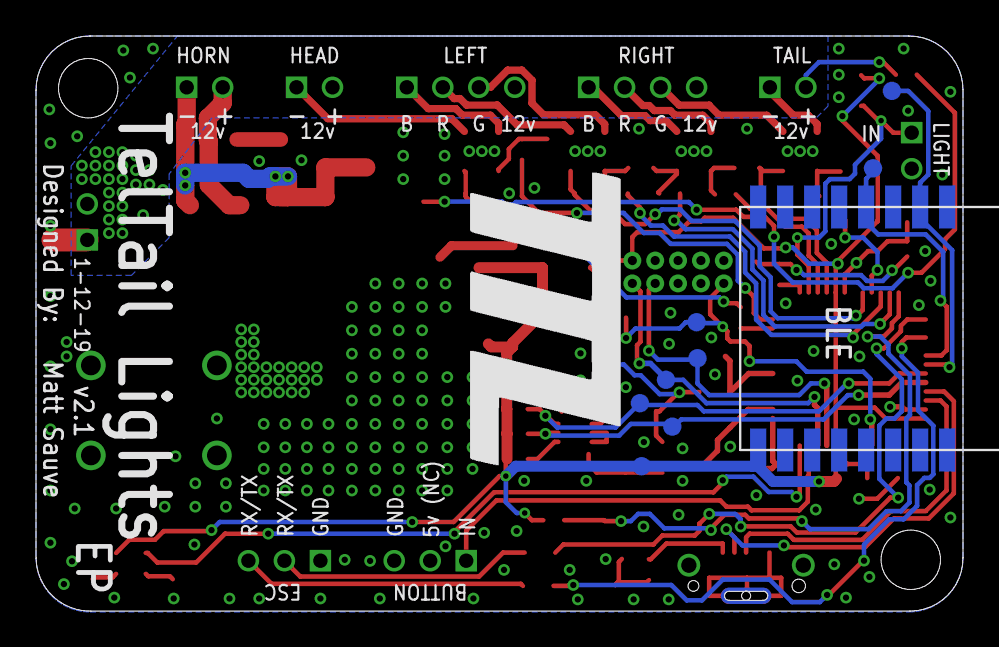
[picture p18: board TelTail Lights EP 2v1.brd from below]

Board: 2 copper layers, 51.5 x 31.9 mm, 88 parts (10 on the bottom side), 61 nets.

Other parts of the board:
U$4, U$5: STAND-OFF
U$22: TTL_LARGE
