Samatthe/TTL-HW/TTL-Lights/Tail Light/1v2/Tail Lights.brd

## EAGLE design TTL-Lights/Tail Light/1v2/Tail Lights.brd (2023-09-26)

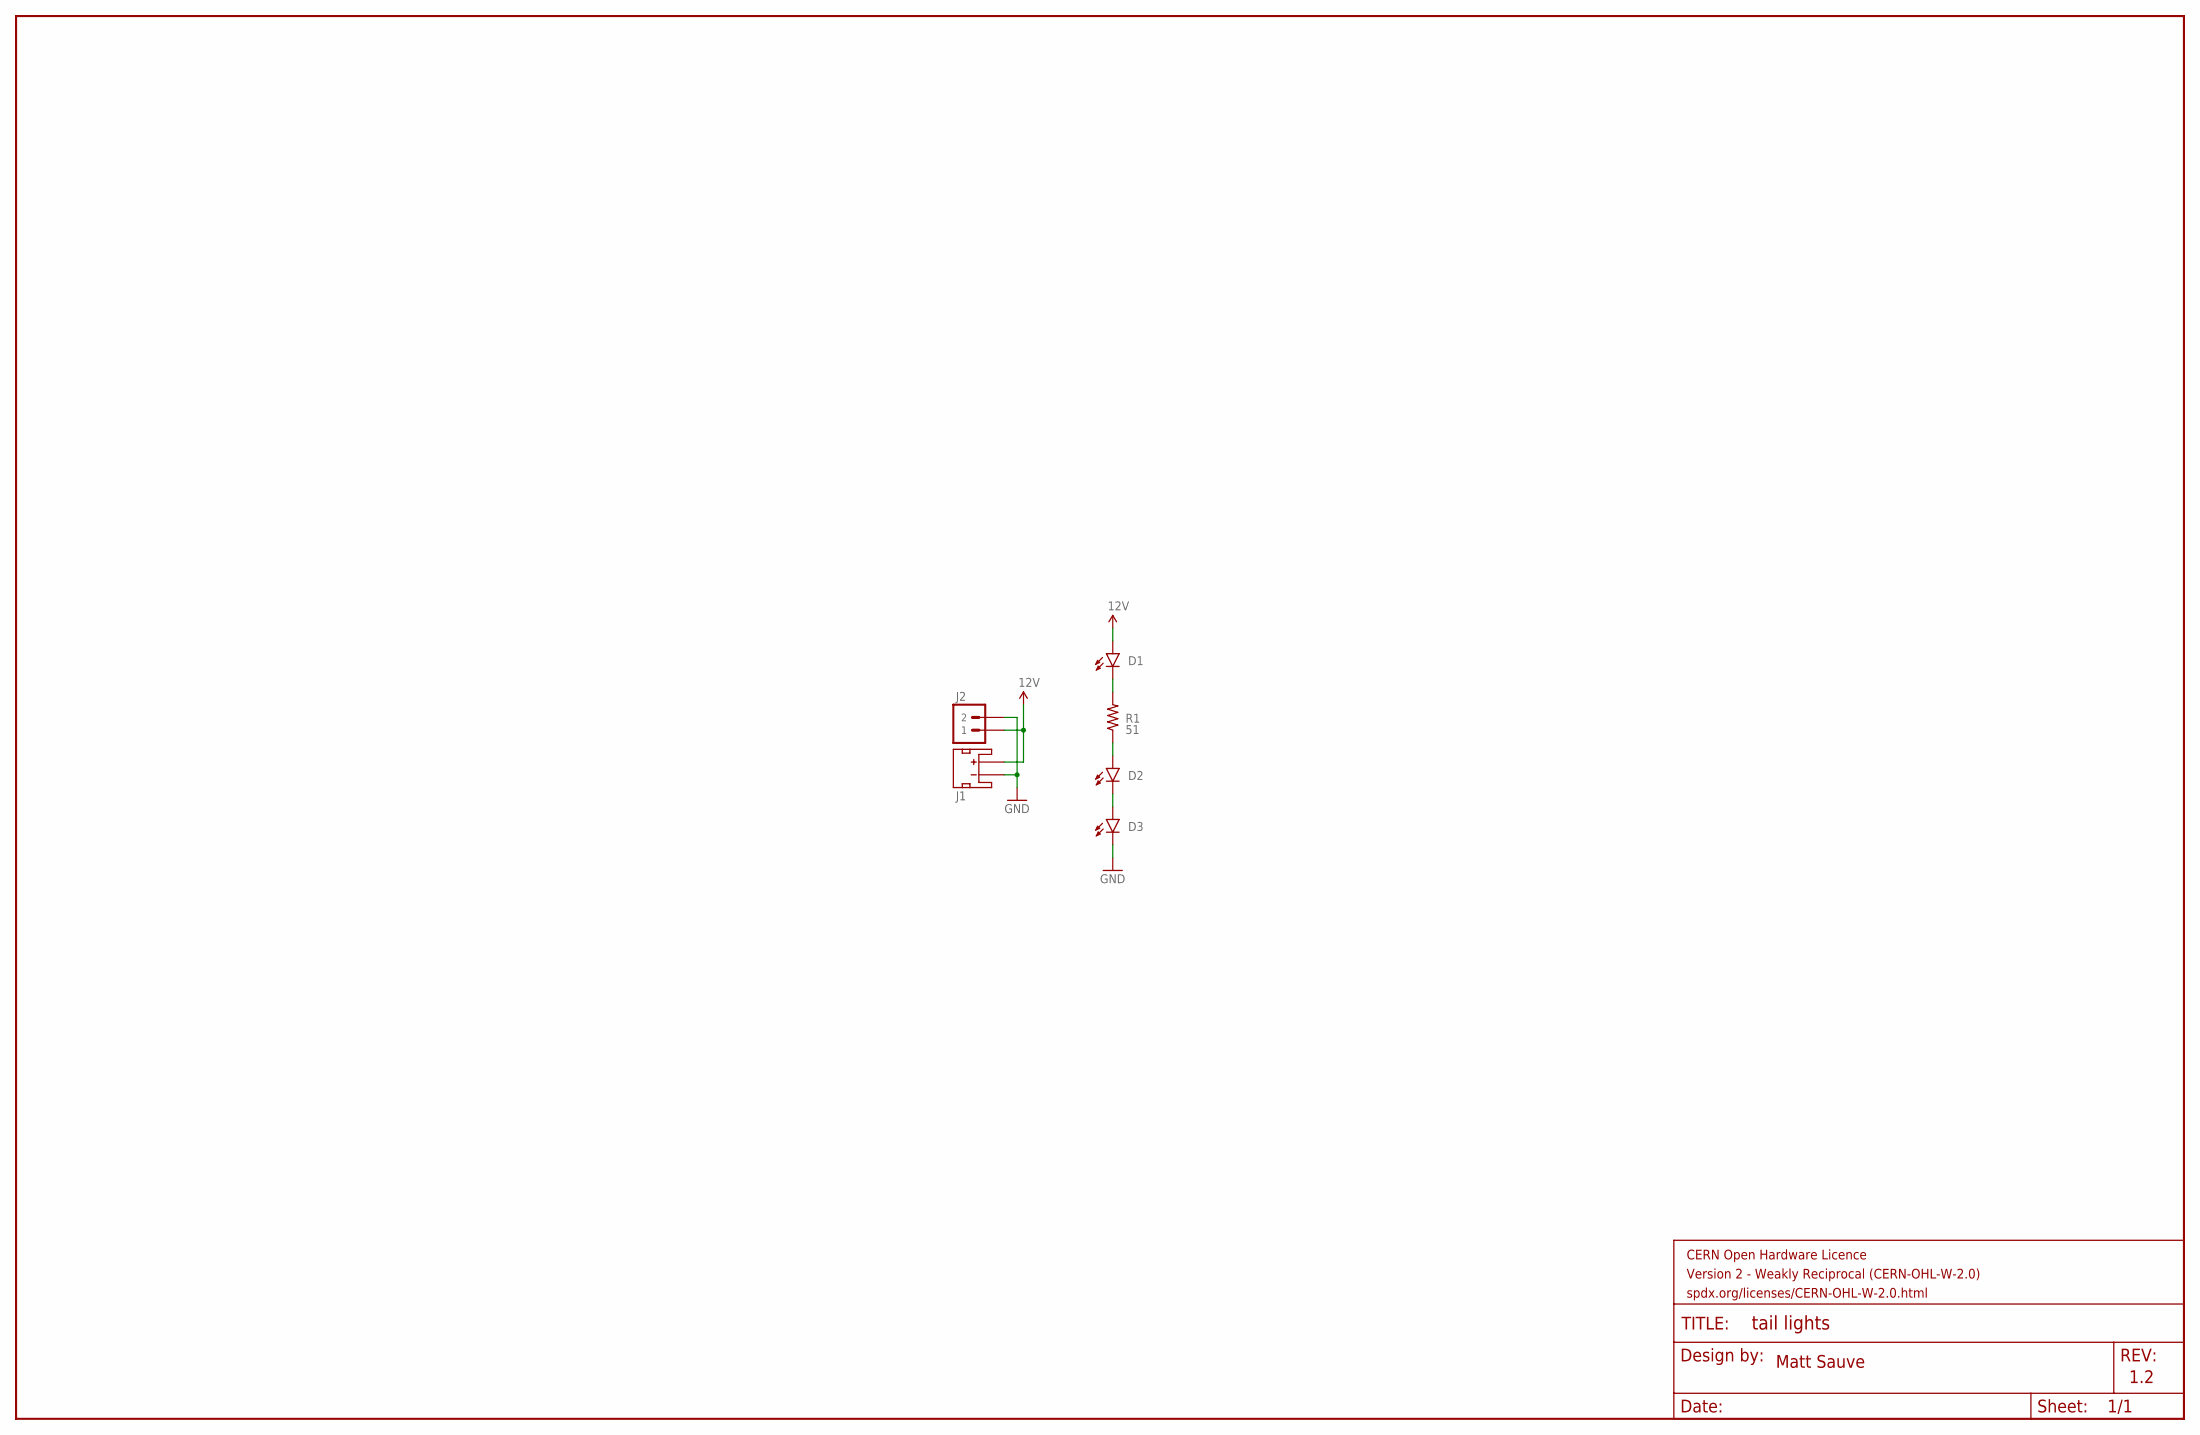
[picture p19: schematic Tail Lights.sch]

Parts:
D1, D2, D3: RED_CREE_LED; 4-SMD
FRAME1: FRAME-LEDGER_CERN_WEAK; CERN_WEAK
J1: JST_2MM_MALE; JST-2-SMD
J2: JST_PH_2POS
R1: 51; R2512

Connections:
12V: D1.P$1 (A), D1.P$2 (A), J1.2 (+), J2.1
GND: D3.P$3 (C), D3.P$4 (C), J1.1 (-), J2.2
unnamed: D2.P$1 (A), D2.P$2 (A), R1.1
unnamed: D1.P$3 (C), D1.P$4 (C), R1.2
unnamed: D2.P$3 (C), D2.P$4 (C), D3.P$1 (A), D3.P$2 (A)

Notes on the sheet:
Matt Sauve
1.2

Board: 2 copper layers, 7 parts (2 on the bottom side), 5 nets, no tracks yet.
