Samatthe/TTL-HW/(notices)

Notices in the files:
parts and their libraries:
SAUVE: Released under the Creative Commons Attribution Share-Alike 4.0 License
SAUVE: https://creativecommons.org/licenses/by-sa/4.0
SAUVE: Released under the CERN Open Hardware Licence Version 2 - Weakly Reciprocal (CERN-OHL-W-2.0)
SAUVE: spdx.org/licenses/CERN-OHL-W-2.0.html
